gregdavill/picodvi/hardware/board/picodvi.pdf

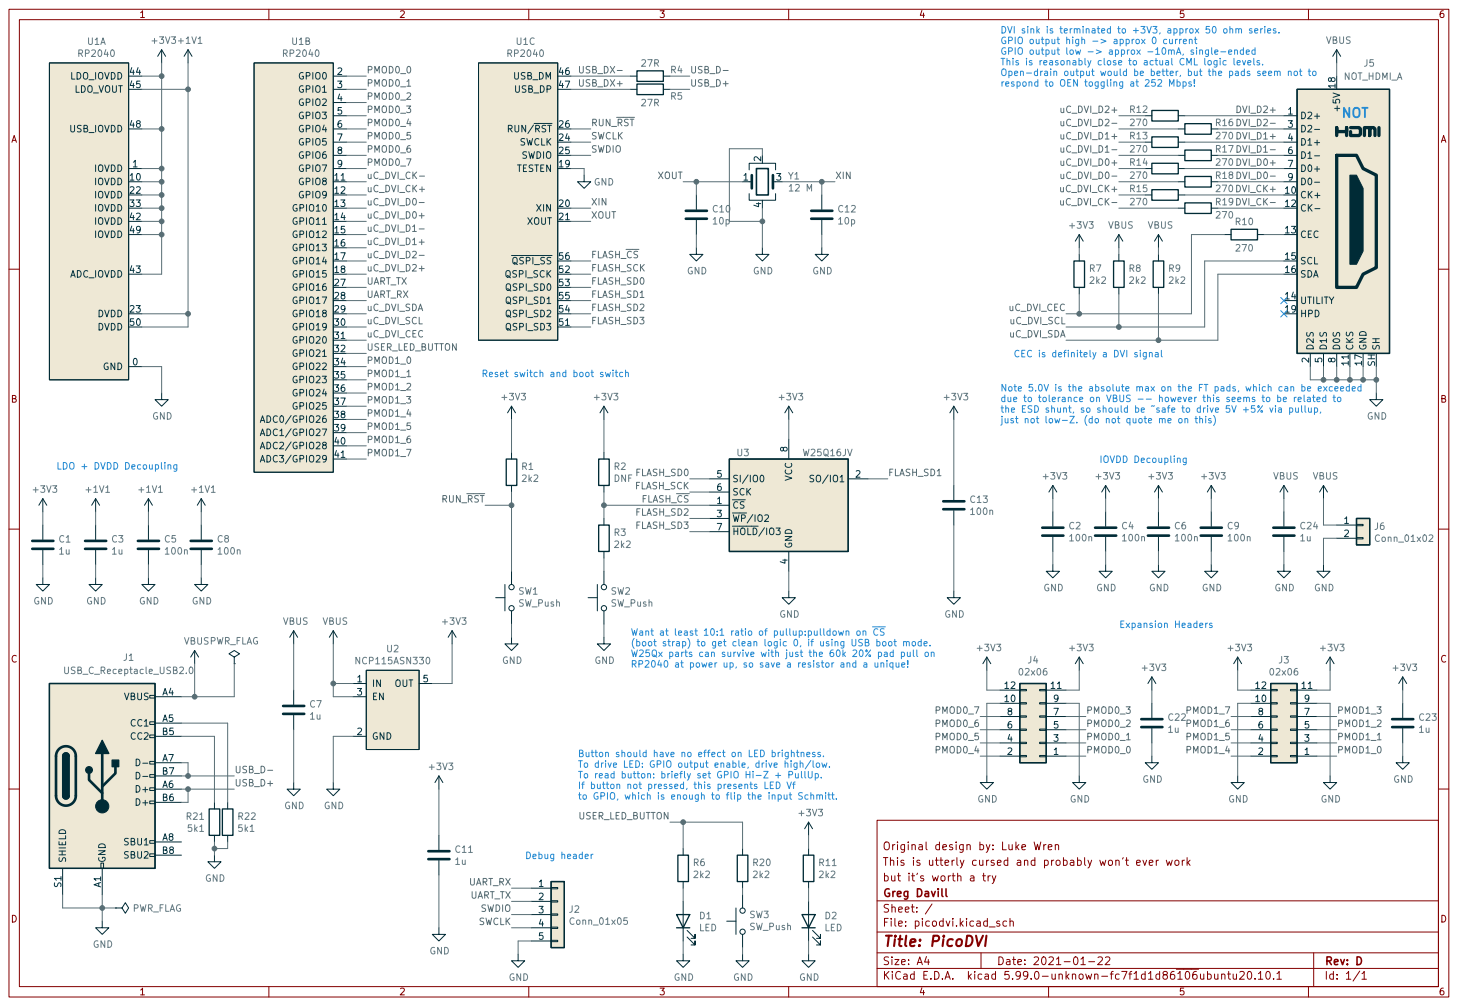
[picture p1: page 1]

DVI sink is terminated to +3V3, approx 50 ohm series.
GPIO output high -> approx 0 current
GPIO output low -> approx -10mA, single-ended
This is reasonably close to actual CML logic levels.
J5 NOT_HDMI_A GND
DVI_CK+ DVI_CK- DVI_D1+ DVI_D2- DVI_D2+

respond to OEN toggling at 252 Mbps! Reset switch and boot switch

Open-drain output would be better, but the pads seem not to

uC_DVI_SDA
CEC is definitely a DVI signal

Note 5.0V is the absolute max on the FT pads, which can be exceeded
due to tolerance on VBUS -- however this seems to be related to
the ESD shunt, so should be ~~safe to drive 5V +5% via pullup,
just not low-Z. (do not quote me on this)

4 SI/IO0 5 SCK 6 ~HOLD~/IO3 7 VCC

Want at least 10:1 ratio of pullup:pulldown on ~CS~
(boot strap) to get clean logic 0, if using USB boot mode.
W25Qx parts can survive with just the 60k 20% pad pull on
RP2040 at power up, so save a resistor and a unique!

Button should have no effect on LED brightness.
To drive LED: GPIO output enable, drive high/low.
To read button: briefly set GPIO Hi-Z + PullUp.
If button not pressed, this presents LED Vf
to GPIO, which is enough to flip the input Schmitt.

Original design by: Luke Wren
This is utterly cursed and probably won't ever work
but it's worth a try
File: picodvi.kicad_sch Sheet: / Greg Davill
