gregdavill/picodvi/hardware/board/picodvi.kicad_pcb

## KiCad design hardware/board/picodvi.kicad_pcb (2021-01-22)

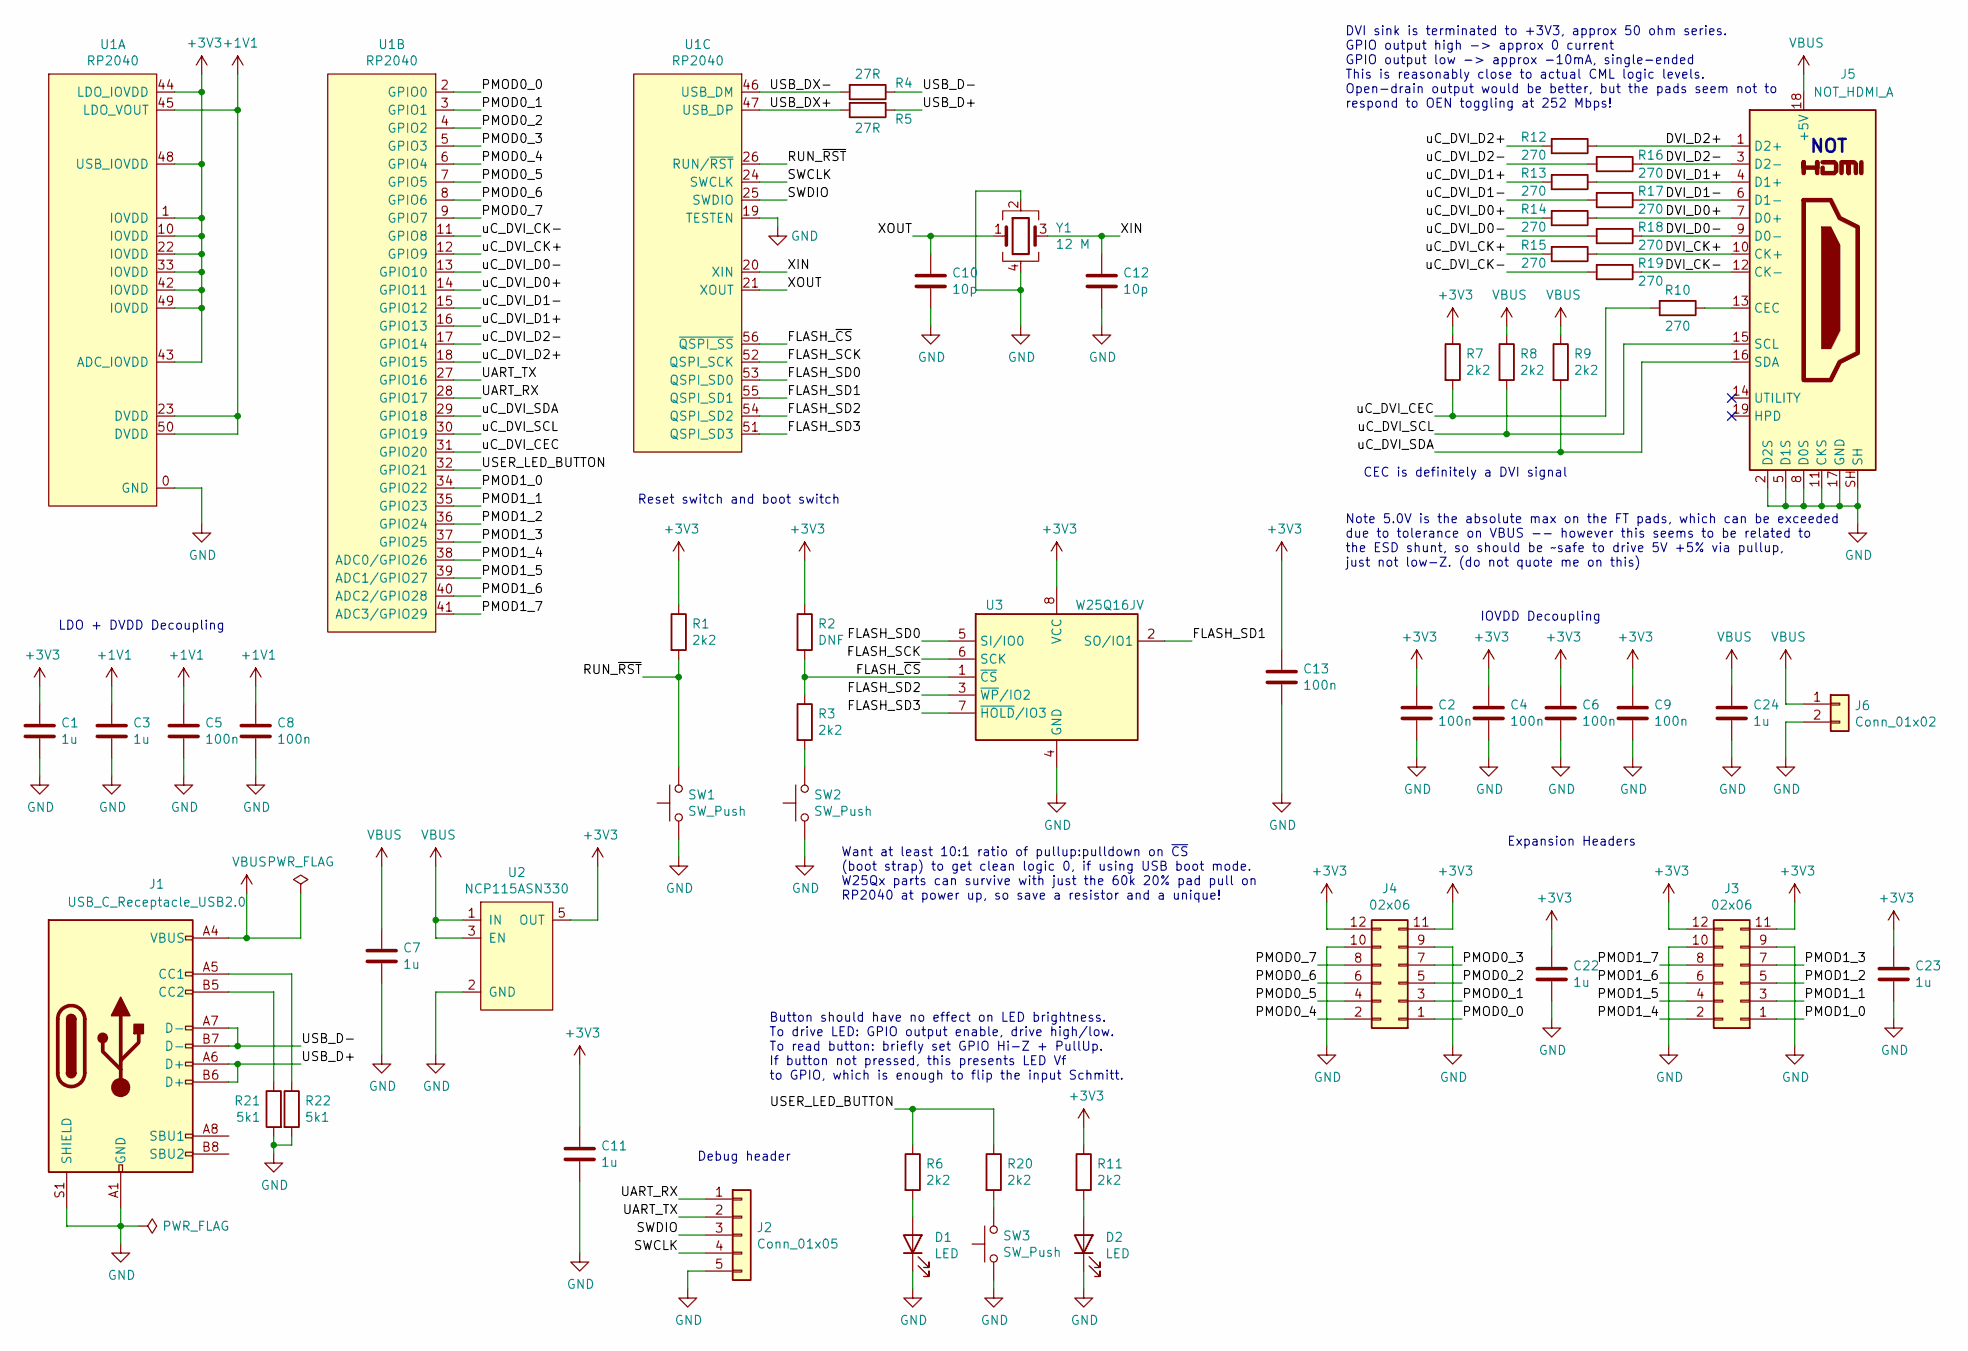
[picture p2: schematic picodvi.kicad_sch]

Parts:
C1, C3, C7, C11, C22, C23, C24: 1u; C_0402_1005Metric
C2, C4, C5, C6, C8, C9, C13: 100n; C_0402_1005Metric
C10, C12: 10p; C_0402_1005Metric
D1, D2: LED; LED_0805_2012Metric
J1: USB_C_Receptacle_USB2.0; USB_C_Receptacle_XKB_U262-16XN-4BVC11
J2: Conn_01x05; PinHeader_1x05_P2.54mm_Vertical
J3, J4: 02x06; PinHeader_2x06_P2.54mm_Horizontal
J5: NOT_HDMI_A; HDMI-SS-53000
J6: Conn_01x02; PinHeader_1x02_P2.54mm_Vertical
R1, R3, R6, R7, R8, R9, R11, R20: 2k2; R_0402_1005Metric
R2: DNF; R_0402_1005Metric
R4, R5: 27R; R_0402_1005Metric
R10, R12, R13, R14, R15, R16, R17, R18, R19: 270; R_0201_0603Metric
R21, R22: 5k1; R_0402_1005Metric
SW1, SW2, SW3: SW_Push; SW_SPST_PTS815
U1: RP2040; QFN-56_EP_7x7_Pitch0.4mm
U2: NCP115ASN330; SOT-23-5
U3: W25Q16JV; WSON-8-1EP_6x5mm_P1.27mm_EP3.4x4mm
Y1: 12 M; Crystal_SMD_3225-4Pin_3.2x2.5mm

Connections:
+1V1: C3.1, C5.1, C8.1, U1.23 (DVDD), U1.45 (LDO_VOUT), U1.50 (DVDD)
+3V3: C1.1, C2.1, C4.1, C6.1, C9.1, C11.1, C13.1, C22.1, C23.1, J3.11, J3.12, J4.11, J4.12, R1.1, R2.1, R7.1, R11.1, U1.1 (IOVDD), U1.10 (IOVDD), U1.22 (IOVDD), U1.33 (IOVDD), U1.42 (IOVDD), U1.43 (ADC_IOVDD), U1.44 (LDO_IOVDD), U1.48 (USB_IOVDD), U1.49 (IOVDD), U2.5 (OUT), U3.8 (VCC)
/DVI_CK+: J5.10 (CK+), R15.1
/DVI_CK-: J5.12 (CK-), R19.1
/DVI_D0+: J5.7 (D0+), R14.1
/DVI_D0-: J5.9 (D0-), R18.1
/DVI_D1+: J5.4 (D1+), R13.1
/DVI_D1-: J5.6 (D1-), R17.1
/DVI_D2+: J5.1 (D2+), R12.1
/DVI_D2-: J5.3 (D2-), R16.1
/FLASH_SCK: U1.52 (QSPI_SCK), U3.6 (SCK)
/FLASH_SD0: U1.53 (QSPI_SD0), U3.5 (SI/IO0)
/FLASH_SD1: U1.55 (QSPI_SD1), U3.2 (SO/IO1)
/FLASH_SD2: U1.54 (QSPI_SD2), U3.3 (~WP~/IO2)
/FLASH_SD3: U1.51 (QSPI_SD3), U3.7 (~HOLD~/IO3)
/FLASH_~CS~: R2.2, R3.1, U1.56 (~QSPI_SS~), U3.1 (~CS)
/PMOD0_0: J4.1, U1.2 (GPIO0)
/PMOD0_1: J4.3, U1.3 (GPIO1)
/PMOD0_2: J4.5, U1.4 (GPIO2)
/PMOD0_3: J4.7, U1.5 (GPIO3)
/PMOD0_4: J4.2, U1.6 (GPIO4)
/PMOD0_5: J4.4, U1.7 (GPIO5)
/PMOD0_6: J4.6, U1.8 (GPIO6)
/PMOD0_7: J4.8, U1.9 (GPIO7)
/PMOD1_0: J3.1, U1.34 (GPIO22)
/PMOD1_1: J3.3, U1.35 (GPIO23)
/PMOD1_2: J3.5, U1.36 (GPIO24)
/PMOD1_3: J3.7, U1.37 (GPIO25)
/PMOD1_4: J3.2, U1.38 (ADC0/GPIO26)
/PMOD1_5: J3.4, U1.39 (ADC1/GPIO27)
/PMOD1_6: J3.6, U1.40 (ADC2/GPIO28)
/PMOD1_7: J3.8, U1.41 (ADC3/GPIO29)
/RUN_~RST~: R1.2, SW1.2, U1.26 (RUN/~RST~)
/SWCLK: J2.4, U1.24 (SWCLK)
/SWDIO: J2.3, U1.25 (SWDIO)
/UART_RX: J2.1, U1.28 (GPIO17)
/UART_TX: J2.2, U1.27 (GPIO16)
/USB_D+: J1.A6 (D+), J1.B6 (D+), R5.1
/USB_D-: J1.A7 (D-), J1.B7 (D-), R4.1
/USB_DX+: R5.2, U1.47 (USB_DP)
/USB_DX-: R4.2, U1.46 (USB_DM)
/USER_LED_BUTTON: R6.1, R20.1, U1.32 (GPIO21)
/XIN: C12.1, U1.20 (XIN), Y1.3
/XOUT: C10.1, U1.21 (XOUT), Y1.1
/uC_DVI_CEC: R7.2, R10.2, U1.31 (GPIO20)
/uC_DVI_CK+: R15.2, U1.12 (GPIO9)
/uC_DVI_CK-: R19.2, U1.11 (GPIO8)
/uC_DVI_D0+: R14.2, U1.14 (GPIO11)
/uC_DVI_D0-: R18.2, U1.13 (GPIO10)
/uC_DVI_D1+: R13.2, U1.16 (GPIO13)
/uC_DVI_D1-: R17.2, U1.15 (GPIO12)
/uC_DVI_D2+: R12.2, U1.18 (GPIO15)
/uC_DVI_D2-: R16.2, U1.17 (GPIO14)
/uC_DVI_SCL: J5.15 (SCL), R8.2, U1.30 (GPIO19)
/uC_DVI_SDA: J5.16 (SDA), R9.2, U1.29 (GPIO18)
GND: C1.2, C2.2, C3.2, C4.2, C5.2, C6.2, C7.2, C8.2, C9.2, C10.2, C11.2, C12.2, C13.2, C22.2, C23.2, C24.2, D1.1 (K), D2.1 (K), J1.A1 (GND), J1.A12 (GND), J1.B1 (GND), J1.B12 (GND), J1.S1 (SHIELD), J2.5, J3.9, J3.10, J4.9, J4.10, J5.2 (D2S), J5.5 (D1S), J5.8 (D0S), J5.11 (CKS), J5.17 (GND), J5.SH, J6.2, R21.2, R22.2, SW1.1, SW2.1, SW3.1, U1.0 (GND), U1.19 (TESTEN), U2.2 (GND), U3.4 (GND), Y1.2, Y1.4
unnamed: D1.2 (A), R6.2
unnamed: D2.2 (A), R11.2
unnamed: J1.A5 (CC1), R22.1
unnamed: J1.B5 (CC2), R21.1
unnamed: J5.13 (CEC), R10.1
unnamed: R3.2, SW2.2
unnamed: R20.2, SW3.2
VBUS: C7.1, C24.1, J1.A4 (VBUS), J1.A9 (VBUS), J1.B4 (VBUS), J1.B9 (VBUS), J5.18 (+5V), J6.1, R8.1, R9.1, U2.1 (IN), U2.3 (EN)
no_connect_67: J5.14 (UTILITY)
no_connect_68: J5.19 (HPD)

Notes on the sheet:
LDO + DVDD Decoupling
Debug header
Button should have no effect on LED brightness. To drive LED: GPIO output enable, drive high/low. To read button: briefly set GPIO Hi-Z + PullUp. If button not pressed, this presents LED Vf to GPIO, which is enough to flip the input Schmitt.
Reset switch and boot switch
Want at least 10:1 ratio of pullup:pulldown on ~CS~ (boot strap) to get clean logic 0, if using USB boot mode. W25Qx parts can survive with just the 60k 20% pad pull on RP2040 at power up, so save a resistor and a unique!
DVI sink is terminated to +3V3, approx 50 ohm series. GPIO output high -> approx 0 current GPIO output low -> approx -10mA, single-ended This is reasonably close to actual CML logic levels. Open-drain output would be better, but the pads seem not to respond to OEN toggling at 252 Mbps!
Note 5.0V is the absolute max on the FT pads, which can be exceeded due to tolerance on VBUS -- however this seems to be related to the ESD shunt, so should be ~~safe to drive 5V +5% via pullup, just not low-Z. (do not quote me on this)
CEC is definitely a DVI signal
IOVDD Decoupling
Expansion Headers
NOT

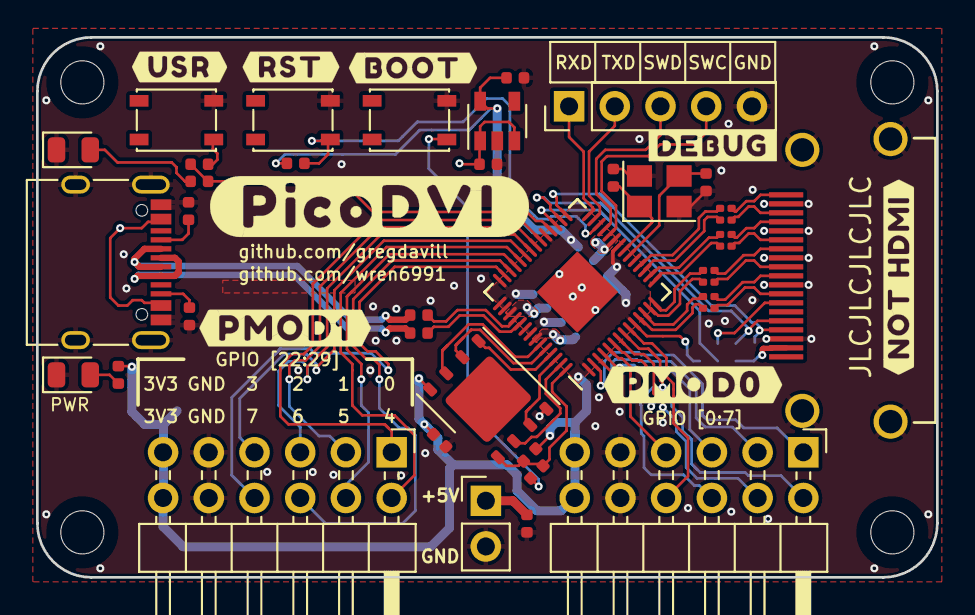
[picture p3: board picodvi.kicad_pcb from above]

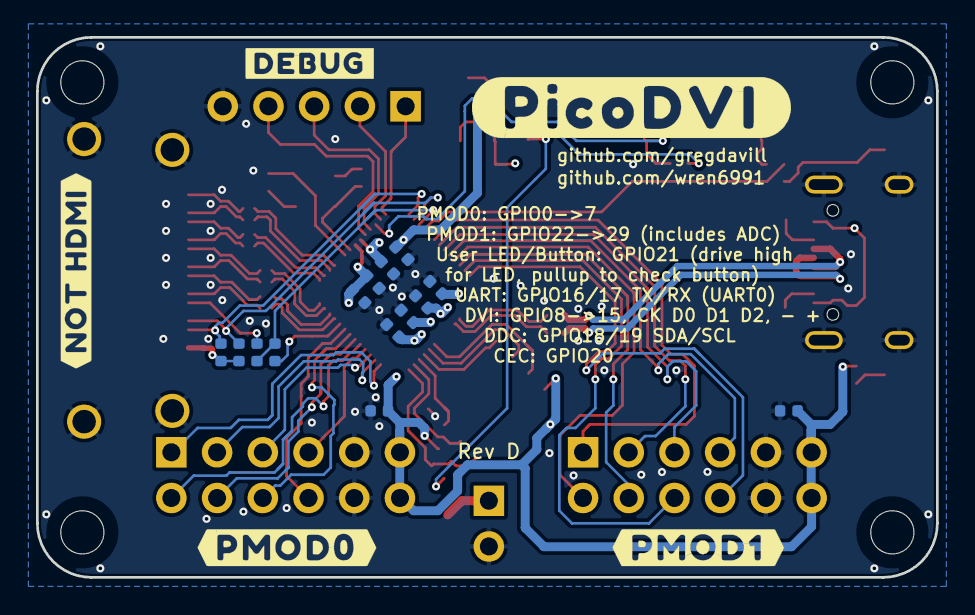
[picture p4: board picodvi.kicad_pcb from below]

Board: 4 copper layers, 50.0 x 30.0 mm, 53 parts (14 on the bottom side), 64 nets.
